maxmiztejm/MR-slider/TODO.txt

1. Display illumination control.
2. Battery charge monitor.
