maxmiztejm/MR-slider/(list of files, cad)

Other CAD files:
HW/MECH/slider_final.DWG
