maxmiztejm/MR-slider/HW/ELECTRONIC/slider_V01.pdf

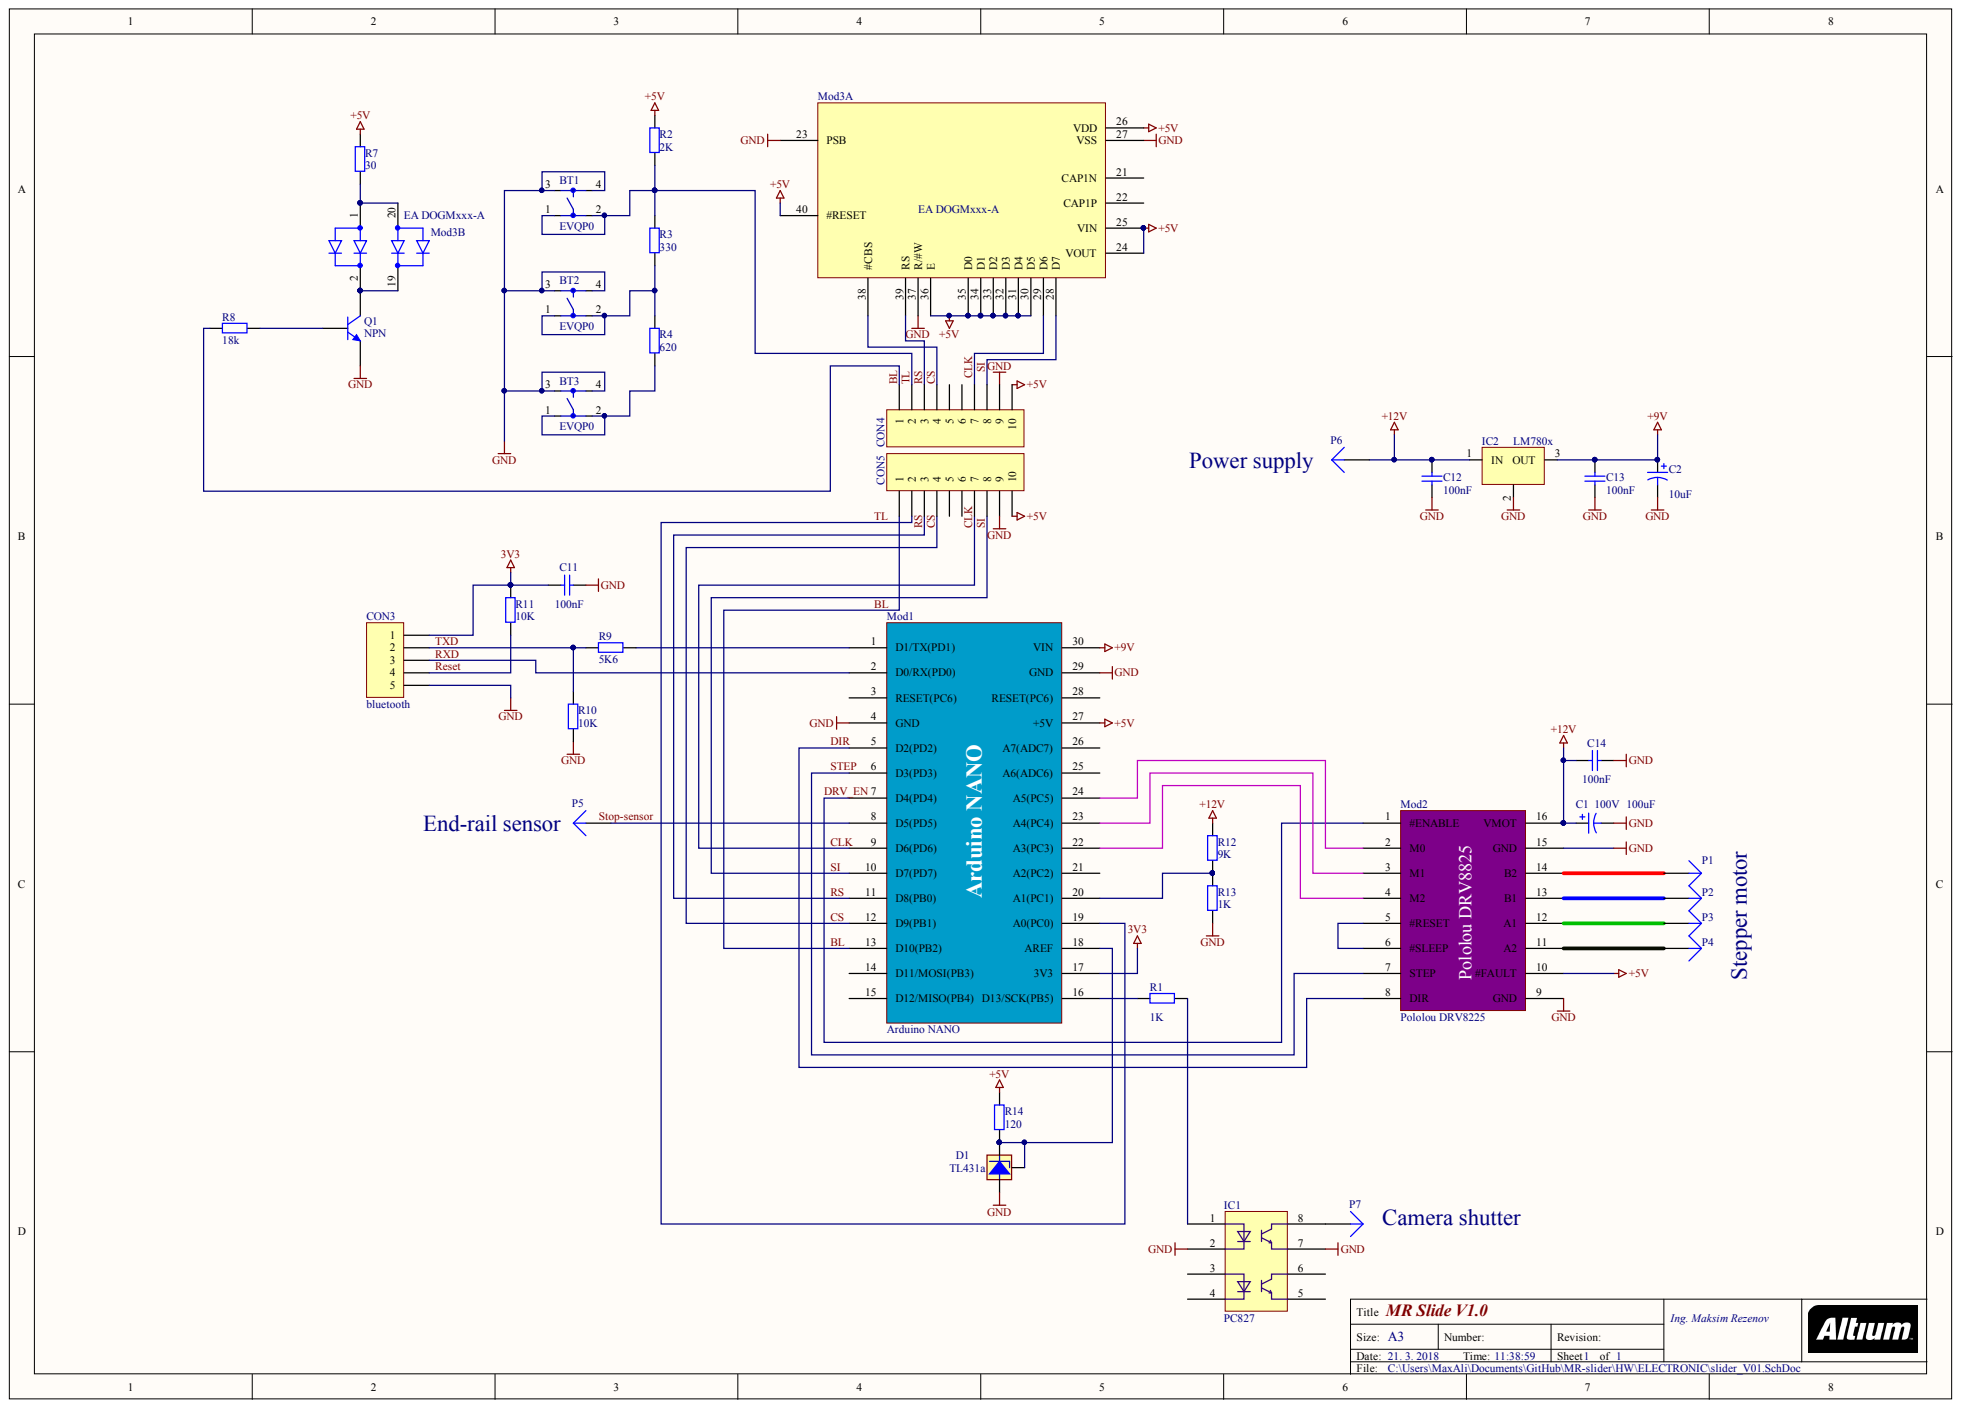
[picture p1: page 1]

TXD
RXD | 5K6 | D0/RX(PD0) 2
Reset

RESET(PC6) 3

MR Slide V1.0 Title | Ing. Maksim Rezenov

Size: A3 | Number: | Revision:
Date: 21. 3. 2018 Time: 11:38:59 | | Sheet 1 of 1

C:\Users\MaxAli\Documents\GitHub\MR-slider\HW\ELECTRONIC\slider_V01.SchDoc
