maxmiztejm/MR-slider/(list of files, drawings)

Other design files:
HW/ELECTRONIC/slider_V01.PcbDoc
HW/ELECTRONIC/slider_V01.PrjPcb
HW/ELECTRONIC/slider_V01.SchDoc
HW/ELECTRONIC/slider_V01_displayboard.PcbDoc
