maxmiztejm/MR-slider/(commit log)

2018-03-04 MR slider update
    [slider_V01.PcbDoc, slider_V01.PrjPcb, slider_V01.SchDoc, slider_V01_displayboard.PcbDoc]
2018-03-04 slider update
    [slider_V01.SchDoc]
2018-03-21 libraries added
    [slider_V01_displayboard.PcbDoc]
2018-12-22 gerber update
    [slider_V01.PcbDoc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]
